Guimli/Vectrex-Repair-Manual/Manuel de réparation Vectrex 20220410.pdf

# Vectrex - Manuel de réparation

par Nicolas Weill
avec l’assistance de Flore Netter Remerciement spécial à Pascal, Jeremy et Gérald pour leurs Vectrex Relecture par les membres de l’association MO5

Révision du 12 mars 2022

*Merci d’envoyer vos commentaires, corrections ou propositions de traduc-tion sur le Github https://github.com/Guimli/Vectrex-Repair-Manual

## Contents

1 Précaution | 7
2 Panne récurente | 7
3 Métodologie de réparation | 9
4 Schématique | 9
5 Relevés Oscilloscope | 15

2

3

4

5

6 Documentation technique et composant de substitution | 77

6

## 1 Précaution

Risque électrique

Images/Electric-Shock.png Les consoles Vectrex contiennent un tube cathodique. De hautes

tensions sont présentes dans l’équipement électronique, même après l’ar-rêt de la console. Ne manipuler pas une Vectrex sans les connaissances électrique spécifiques requises.

## 2 Panne récurente

### 2.1 Pas de son et pas d’image

- Vérifier l’interrupteur SW301. Cet interrupteur est connu pour se gripper avec les années. Il faut alors ouvrir l’arrière, ajouter du dégrippant et actionner les contacts pour diffuser le dégrimpant. Passer eventuellement du papier de verre sur les contact si vous constatez une oxydation.
- Vérifier le fusible F101. Remplacer le fusible si besoin. Si le fusible saute systématiquement, les cas les plus fréquents de court circuit se situent sur les composant IC101 (LM340), IC102 (7905) et IC401 (LM379).

### 2.2 Pas de son et point blanc

- IC207 (PIA 6522) est le principale responsable des pannes sur la console Vectrex. Le remplacer est toujours la première opération à effectuer.
- L’absence de son indique que l’ensemble processeur, ROM, RAM et PIA ne fonctionne pas correctement. Si le PIA a déjà été remplacé sans succès, la cause la plus probable est une corruption de la ROM IC201 (2363).
- Cas de pannes multiples : Il est possible que plusieurs pannes brouilles l’analyse. Par exemple, une panne partielle de l’interrupteur SW301 pourra interrompre le -13V provoquant un point blanc. Et une panne de l’ampli-ficateur audio IC103 (LM386) pourra provoquer une absence de son.

### 2.3 Présence de son, mais point blanc

- Vérifier la présence des tensions sur J204 (+5V, -5V, -13V). L’absence de -13V génére un point blanc et peut révéler un problème avec l’interrupteur SW301 ou la diode zener DZ102.
- La cause la plus fréquente de point blanc sur l’écran est une panne de IC207 (PIA 6522).

7

- Il y a de nombreuses pannes pouvant générer un point blanc. Reportez vous aux relevés d’oscilloscope pour corriger les problèmes d’images/point blanc.

### 2.4 Autre problème d’image

- Reportez vous aux relevés d’oscilloscope pour corriger les problèmes d’images/point blanc.
- Un problème d’image rare mais difficile à diagnotiquer peut provenir du
cable J301. Les contacts à l’interieur sont sertis et non soudés. Il est donc possible de voir apparitre de l’oxydation sur les contact ou dans la jonc-tion cable-contact. Ce problème est invisble de l’extéruieur et nécessite de retirer les contacts du cable pour inspection.
- Problème rare d’image se décalant lors des mouvements de la manette : remplacer IC302 (CD4052D).

8

## 3 Métodologie de réparation

Une approche efficace de diagnotic consiste à diviser le circuit en section et proceder à une analyse par dichotomie.

- Commencer toujours par vérifier le fonctionnement de l’interrupteur SW301. Celui-ci peut-être partiellement défectueux. Les niveaux de tensions se-ront néanmoins correct. Mais une seule des deux bobines du secondaire du transformateur T102 sera exploité, générant une usure et une surchauffe de plusieurs éléments de l’alimentaion. Ainci qu’une instabillité plus grande sur les niveaux de tension. Ce qui générera des vibration de l’image.
- Vérifier les niveau de tension sur le connecteur J204.
- Vérifier les broches 3, 6,9 et 10 de IC302 (4052B). Si le signaux de ces bro-chezs sont incorrects, alors le problème se situe dans la partie numérique de la LogicBoard (IC201 à IC208, IC301 et IC304).

## 4 Schématique

### 4.1 PowerBoard

9

1N4005 D504

# 0.3uH 0.8A GND


To view a copy of this license, visit http://creativecommons.org/licenses/by-sa/4.0/ Attribution-ShareAlike 4.0 International License. This work is licensed under the Creative Commons R404

File: PowerBoard.kicad_sch Sheet: / or send a letter to Creative Commons, PO Box 1866, Mountain View, CA 94042, USA.

Id: 1/1 Title: Vectrex Power Board

### 4.2 LogicBoard

11

IRQB 21 RWB 22 CS2B 23 CS1 24 PHI2 25 D7 26 D6 27 D5 28 D4 29 | PA1 | 3 D3 30 D2 31 D1 32 D0 33 RESB 34 RS3 35 RS2 36 RS1 37 RS0 38 | CA2 39 PA2 | 4 CA1 40 PA3 | 5 PA4 | 6 PA5 | 7 PA6 | 8 PA7 | 9
+5V | +5VA R²²⁴ ⁶⁸⁰

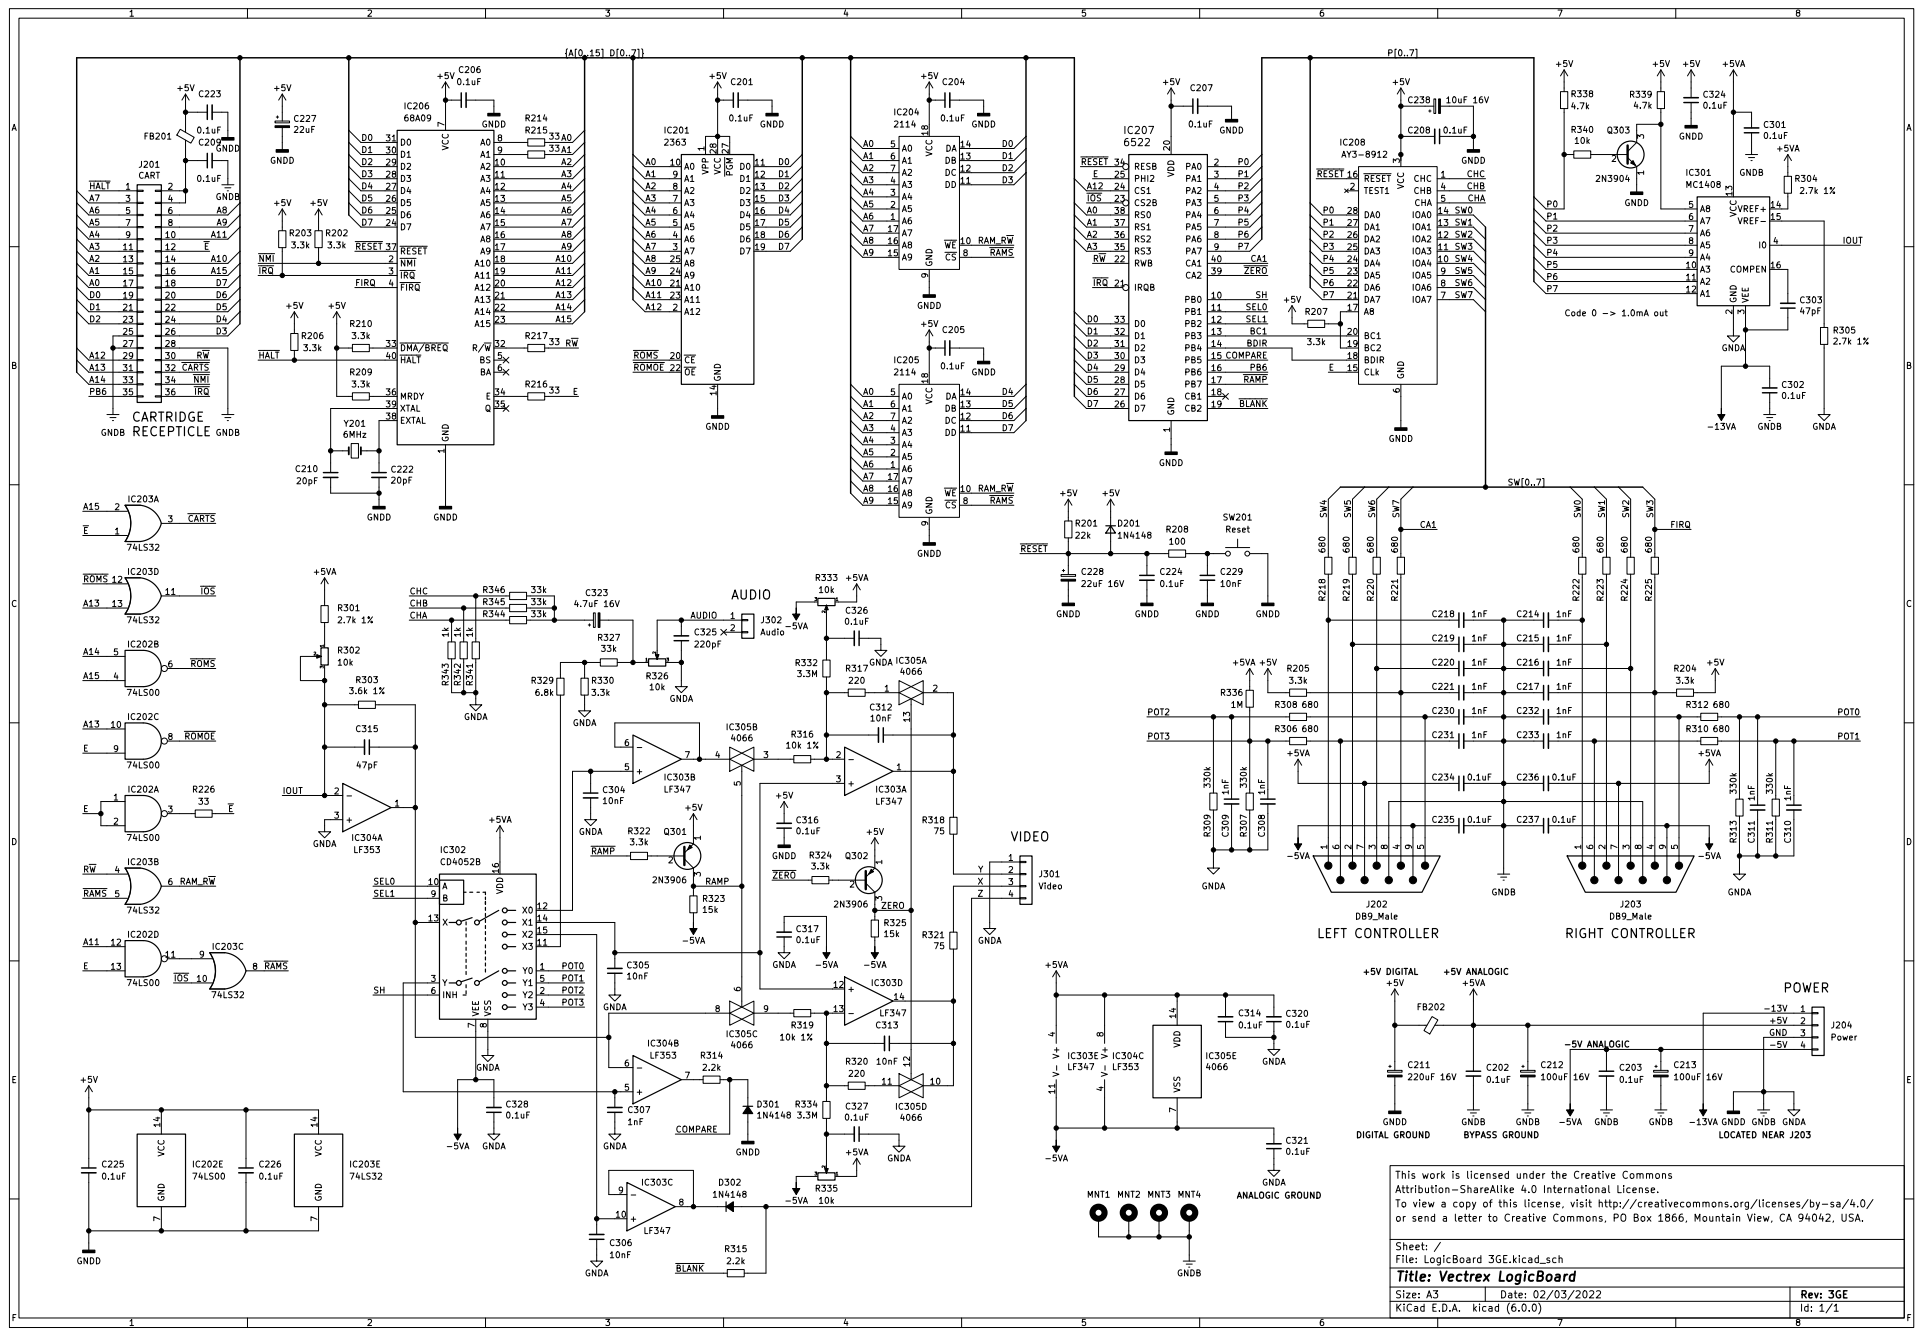
[picture p23: page 12]

1 A2 10 A3 11 A4 12 A5 13 A6 14 A7 15 A8 16 A9 17 A10 18 A11 19 ~{NMI} 2 A12 20 A13 21 A14 22 A15 23 D7 24 D6 25 D5 26 D4 27 D3 28 D2 29 ~{IRQ} 3 D1 30 D0 31 R/~{W}32 ~{DMA/BREQ} 33 E

1 A0 10 D0 11 D1 12 D2 13 GND 14 D3 15 D4 16 D5 17 D6 18 D7 19 A12 2 ~{CE} 20 A10 21 ~{OE} 22 A11 23 A9 24 A8 25 ~{PGM}27 VCC 28 A7 3 A6 4 A5 5 A4 6 A3 7 A2 8 A1 9

LOCATED NEAR J203 ANALOGIC GROUND VIDEO

To view a copy of this license, visit http://creativecommons.org/licenses/by-sa/4.0/ Attribution-ShareAlike 4.0 International License. This work is licensed under the Creative Commons

File: LogicBoard 3GE.kicad_sch Sheet: / or send a letter to Creative Commons, PO Box 1866, Mountain View, CA 94042, USA.

Id: 1/1 Title: Vectrex LogicBoard

### 4.3 CRT Board

13


To view a copy of this license, visit http://creativecommons.org/licenses/by-sa/4.0/ Attribution-ShareAlike 4.0 International License. This work is licensed under the Creative Commons YOKE401 HORIZONTAL C515

File: CRTBoard.kicad_sch Sheet: / or send a letter to Creative Commons, PO Box 1866, Mountain View, CA 94042, USA.

Id: 1/1 Title: Vectrex CRT Board

## 5 Relevés Oscilloscope

Les relevés d’oscilloscope sont classés par identifiant de composant.. Reportez vous au chapitre Métodologie de diagnostic pour ...

### 5.1 IC201 - 2363

Description : ROM interne contenant le programme d’initialisation de la Vectrex, ainsi que le jeu Minestorm.

Une corruption de la ROM peut être détecté par un reset régulier du processeur comme dans le relevé oscilloscope ci-dessous correspondant à une des broches d’adresse du processeur :


Il est necessaire de disposer d’une autre ROM déjà programmée pour remplacer IC201. Il est possible de remplacer la ROM par une EPROM de type 27C64.
La lecture du contenu de la ROM dans un programmeur compatible doit retourner les checksums 7931, B796 ou 7ADB. Les différentes versions de ROM sont interchangeables dans les différentes versions de Vectrex. La version la plus réçente, et donc à préférer, est la version dont le checksum est 7ADB.

15

### 5.1.1 Broche 1 (VPP)

Tension de programmation. Connecté au +5V logique.

### 5.1.2 Broche 2 à 10, 21, 23, 24,25 (A0 à A12)

Voir IC206 Broches 8 à 21 (A0 à A13).

### 5.1.3 Broche 11 à 13 et 15 à 19 (D0 à D7)

Voir IC206 Broches 24 à 31 (D0 à D7).

### 5.1.4 Broche 14 (GND)

Masse logique, 0V.

### 5.1.5 Broche 20 (ChipEnable)

Voir IC202 Broche 6 (Porte 2 sortie - ROMS).

### 5.1.6 Broche 22 (OutputEnable)

Voir IC202 Broche 8 (Porte 3 sortie - ROMOE).

### 5.1.7 Broche 27 (PGM)

Utilisé pour la programmation de la PROM en usine. Connecté au +5V logique.

### 5.1.8 Broche 28 (VCC)

Alimentation, +5V logique.

16

### 5.2 IC202 - 74LS00

Description : Quadruple porte NAND

### 5.2.1 Broche 1 et 2 (Porte 1 entrée - Enable)

Les broches 1 & 2 sont connectés à la broche 34 du processeur IC206 (broche Enable).
Voir IC206 Broche 34 (Enable).

### 5.2.2 Broche 3 (Porte 1 sortie - Enable)

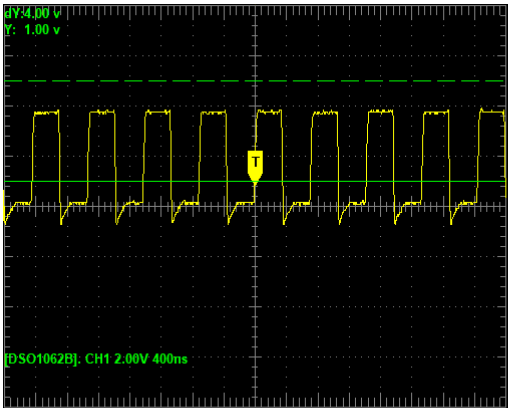
[picture p24: figure]

- En cas d’absence de signal, vérifier les broches 1 et 2 de IC202. Si les signaux sont correct, remplacer IC202.

### 5.2.3 Broche 4 et 5 (Porte 2 entrée - A14 et A15)

Voir IC206 Broches 22 et 23 (A14 et A15).

### 5.2.4 Broche 6 (Porte 2 sortie - ROMS)

Cette broche est connectée a la broche OE (Output Enable) de la ROM IC201. Elles devraient toujours être a un niveau de tension de 0V sauf en cas d’utilisa-

17 tion d’une cartouche de jeu. Si ce n’est pas le cas, vérifier les briches 4 et 5 de IC202. Remplacer IC202 si nécessaire.

### 5.2.5 Broche 7 (GND)

Masse, 0V

### 5.2.6 Broche 8 (Porte 3 sortie - ROMOE)

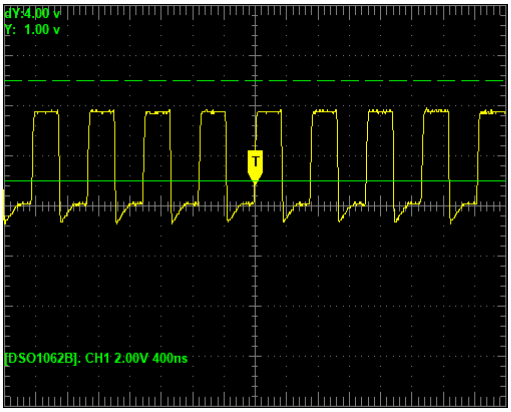
[picture p25: figure]

### 5.2.7 Broche 9 (Porte 3 entrée - Enable)

Voir IC206 Broche 34 (Enable).

- La broche 9 est connectés à la broche 34 du processeur IC206 (broche Enable). Une absence de signal sur cette broche indique un problème avec le processeur. Vérifier R216, XTAL201, et remplacer le processeur IC206 si nécessaire.

18

### 5.2.8 Broche 10 (Porte 3 entrée - A13)

19

### 5.2.9 Broche 11 (Porte 4 sortie)


20

### 5.2.10 Broche 12 (Porte 4 entrée - A11)

### 5.2.11 Broche 13 (Porte 4 entrée - Enable)

Voir IC206 Broche 34 (Enable)

- La broche 13 est connectés à la broche 34 du processeur IC206 (broche Enable). Une absence de signal sur cette broche indique un problème avec le processeur. Vérifier R216, XTAL201, et remplacer le processeur IC206 si nécessaire.

### 5.2.12 Broche 14 (VCC)

Alimentation +5V continu.

21

### 5.3 IC203 - 74LS32

Description : Quadruple porte OR

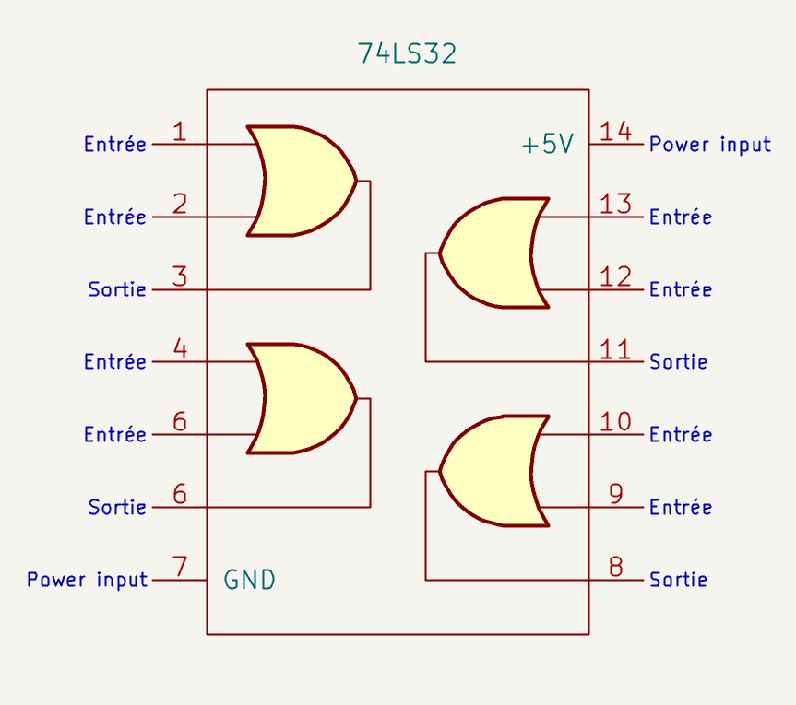
[picture p26: figure]

### 5.3.1 Broche 1 (Porte 1 entrée - Enable)

Voir IC202 Broche 3 (Porte 1 sortie - Enable).

22

### 5.3.2 Broche 2 (Porte 1 entrée - A15)

23

### 5.3.3 Broche 3 (Porte 1 sortie - CARTS)

### 5.3.4 Broche 4 (Porte 2 entrée - RW)

Voir IC206 Broche 32 (RW).

### 5.3.5 Broche 5 (Porte 2 entrée - RAMS)

Voir IC203 Broche 8 (Porte 3 sorite - RAMS).

24

### 5.3.6 Broche 6 (Porte 2 sortie - RAM_RW)

### 5.3.7 Broche 7 (GND)

Masse logique, 0V.

25

### 5.3.8 Broche 8 (Porte 3 sorite - RAMS)

26

### 5.3.9 Broche 9 (Porte 3 entrée)

### 5.3.10 Broche 10 (Porte 3 entrée - IOS)

Voir IC203 Broche 11 (Porte 4 sortie - IOS).

27

### 5.3.11 Broche 11 (Porte 4 sortie - IOS)

### 5.3.12 Broche 12 (Porte 4 entrée - ROMS)

Voir IC202 Broche 6 (Porte 2 sortie - ROMS).

28

### 5.3.13 Broche 13 (Porte 4 entrée - A13)

### 5.3.14 Broche 14 (VCC)

Alimentation +5V logique.

29

### 5.4 IC204, IC205 - 2114

Description : RAM 1K×4bits, 300ns

### 5.4.1 Broche 1 à 7, 15, 16, 17 (A0 à A9)

Voir IC206 Broches 8 à 21 (A0 à A13).

### 5.4.2 Broche 8 (ChipSelect)

Voir IC203 Broche 8 (Porte 3 sorite - RAMS).

### 5.4.3 Broche 9 (GND)

Masse logique, 0V.

### 5.4.4 Broche 10 (WriteEnable)

Voir IC203 Broche 6 (Porte 2 sortie - RAM_RW).

### 5.4.5 Broche 11 à 14 (DA à DD)

Voir IC206 Broches 24 à 31 (D0 à D7).

### 5.4.6 Broche 18 (VCC)

Alimentation +5V logique.

30

### 5.5 IC206 - 68A09

Decription : Processeur 8bits cadencé à 1,5 MHz

### 5.5.1 Broche 1 (GND)

Masse logique, 0V.

### 5.5.2 Broche 2 (NMI)

Cette broche devrait être a +5V, sauf en cas d’utilisation de certaines cartouches de jeu spécifique.

### 5.5.3 Broche 3 (IRQ)

Cette broche devrait être a +5V, sauf en cas d’utilisation de certaines cartouches de jeu spécifique.

### 5.5.4 Broche 4 (FIRQ)

Cette broche devrait être a +5V, sauf en ca d’appuie sur le bouton 4 de la manette de droite.

### 5.5.5 Broche 7 (VCC)

Alimentation +5V logique.

31

### 5.5.6 Broches 8 à 21 (A0 à A13)

32

### 5.5.7 Broches 22 et 23 (A14 et A15)

- Ces broches devraient toujours être à un niveau de tension de 4V, sauf en cas d’utilisation d’une cartouche de jeu. Si ce n’est pas le cas, vérifier XTAL201, C210 et C222, et remplacer IC206 si nécessaire.

33

### 5.5.8 Broches 24 à 31 (D0 à D7)

34

### 5.5.9 Broche 32 (RW)

Images/IC206/pin32.bmp

### 5.5.10 Broche 33 (DMA)

Cette broche est connecté au +5V logique.

35

### 5.5.11 Broche 34 (Enable)

Images/IC206/pin34.bmp

- Une absence de signal sur cette broche indique un problème avec le processeur. Vérifier R216, XTAL201, et remplacer le processeur IC206 si nécessaire.

36

### 5.5.12 Broche 35 (Q)

### 5.5.13 Broche 36 (MReady)

Cette broche est connecté au +5V logique.

### 5.5.14 Broche 37 (Reset)

Réinitialise IC206, IC207 et IC208. Actif sur un niveau bas.

- Cette broche devrait être a +5V sauf si vous appuyez sur le bouton Reset. Si ce n’est pas le cas, remplacer C228, C224, C229 et D201.

37

### 5.5.15 Broche 38 (ExTal)

- Le quartz étant un composant sensible, cette mesure nécessite de postion-ner votre sonde d’oscilloscope en mode 10X.
- En cas d’absence de signal, remplacer Y201, C210, C222. Puis remplacer IC206 si nécessaire.

38

### 5.5.16 Broche 39 (XTal)

- Le quartz étant un composant sensible, cette mesure nécessite de postion-ner votre sonde d’oscilloscope en mode 10X.
- En cas d’absence de signal, remplacer Y201, C210, C222. Puis remplacer IC206 si nécessaire.

### 5.5.17 Broche 40 (Halt)

39

### 5.6 IC207 - 6522

Decription : Extension de port pour processeur 68A09

### 5.6.1 Broche 1 (GND)

Masse logique, 0V.

### 5.6.2 Broche 2 à 9 (PA0 à PA7)

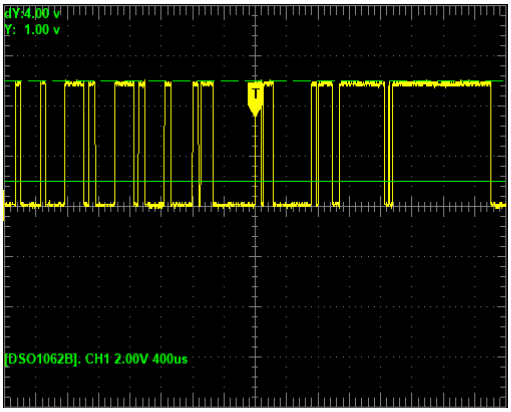
[picture p27: figure]

### 5.6.3 Broche 10 (PB0)

Voir IC302 Broche 6 (Inhibit)

### 5.6.4 Broche 11 et 12 (PB1 & PB2)

Voir IC302 Broche 9 et 10 (Select A et B)

40

### 5.6.5 Broche 13 (PB3)

41

### 5.6.6 Broche 14 (PB4)

42

### 5.6.7 Broche 15 (PB5)

### 5.6.8 Broche 16 (PB6)

Cette broche devrait être a +5V, sauf en cas d’utilisation de certaines cartouches de jeu spécifique.

43

### 5.6.9 Broche 17 (PB7)

44

### 5.6.10 Broche 19 (CB2)

### 5.6.11 Broche 20 (VCC)

Alimentation +5V logique.

### 5.6.12 Broche 21 (IRQB)

Voir IC206 Broche 3 (IRQ).

### 5.6.13 Broche 22 (RWB)

Voir IC206 Broche 32 (RW).

### 5.6.14 Broche 23 (CS2B)

Voir IC203 Broche 11 (Porte 4 sortie - IOS).

### 5.6.15 Broche 24 (CS1)

Voir IC201 Broches 8 à 21 (A0 à A13).

45

### 5.6.16 Broche 25 (Enable)

Voir IC206 Broche 34 (Enable).

### 5.6.17 Broche 26 à 33 (D0 à D7)

Voir IC206 Broches 24 à 31 (D0 à D7).

### 5.6.18 Broche 34 (Reset)

Voir IC206 Broche 37 (Reset).

### 5.6.19 Broche 35 et 38 (A0 à A3)

Voir IC206 Broches 8 à 21 (A0 à A13).

### 5.6.20 Broche 39 (CA2)

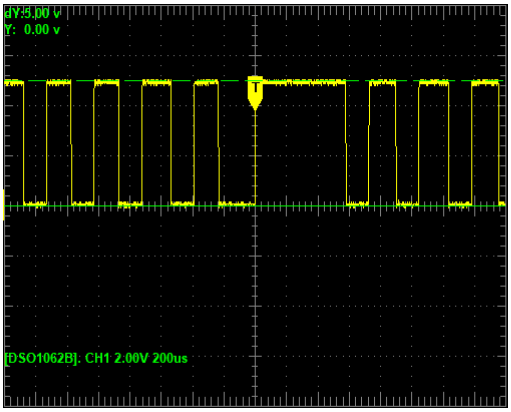
[picture p28: figure]

### 5.6.21 Broche 40 (CA1)

46

### 5.7 IC208 - AY-3-8912

Description : Générateur de son

### 5.7.1 Broche 1, 4 et 5 (CHC, CHB, CHA)

### 5.7.2 Broche 3 (VCC)

Alimentation, +5V logique.

### 5.7.3 Broche 6 (GND)

Masse logique, 0V.

### 5.7.4 Broche 7 à 14 (IOA0 à IOA7)

Connecté aux boutons des manettes. En l’absence d’activité des manettes, ces broches devraient retournées +5V.

### 5.7.5 Broche 15 (Clock)

Voir IC206 Broche 34 (Enable)

### 5.7.6 Broche 16 (Reset)

Voir IC206 Broche 37 (Reset)

### 5.7.7 Broche 17 (A8)

Connecté au +5V logique via R207.

### 5.7.8 Broche 18 (BDir)

Voir IC207 Broche 14 (PB4)

### 5.7.9 Broche 19 (BC2)

Connecté au +5V logique via R207.

### 5.7.10 Broche 20 (BC1)

Voir IC207 Broche 13 (PB3)

### 5.7.11 Broche 21 à 28 (DA0 à DA7)

Voir IC207 Broche 2 à 9 (PA0 à PA7)

47

### 5.8 IC301 - MC-1408P8

Description : convertisseur numérique-analogique 8 bits.

### 5.8.1 Broche 1 (Range / Non connecté)

Non utilisé.

### 5.8.2 Broche 2 (GND)

Masse analogique, 0V.

### 5.8.3 Broche 3 (VEE)

-13V analogique.

### 5.8.4 Broche 4 (IOUT)

Il n’est pas possible d’effectuer des mesures fiables sur cette broche. Mesurer IC302 Broche 13 (Common X) pour vérifier le fonctionnement de IC301.

### 5.8.5 Broche 5 à 12 (DA0 à DA7)

Voir IC207 Broche 2 à 9 (PA0 à PA7)

### 5.8.6 Broche 13 (VCC)

Alimentation, +5V analogique.

### 5.8.7 Broche 14 (VREF+)

+5V analogique via R304.

### 5.8.8 Broche 15 (VREF-)

Masse analogique via R305.

### 5.8.9 Broche 16 (Compensation)

Environ -10V continu, via C303.

48

### 5.9 IC302 - 4052B

Description : double multiplexeur/démultiplexeur.

Le premier multiplexeur prend en entré (broche 13) le signal en provenance du DAC IC301. Et redirige ces signaux en fonction des besoins vers les broches 11 (son digitalisé), 12 (signal vidéo vertical), 14 (?) et 15 (intensité de l’image). Le second multiplexeur est utilisé pour sélectionner le potentiomètre des manettes analogique (broche 1, 2, 4 et 5) qui devra être lu (broche 3). L’analyse de ces broches est donc inutile pour corriger un problème d’image de la Vectrex.

### 5.9.1 Broche 1, 2, 4 et 5 (Y channels In/Out)

Broche de lecture des potentiomètres des joysticks. Sans interet pour réparer les problème commum de la Vectrex.

### 5.9.2 Broche 3 (Common Y)

Broche de sortie des potentiomètres des joysticks. Sans interet pour réparer les problème commum de la Vectrex.

### 5.9.3 Broche 6 (Inhibit)

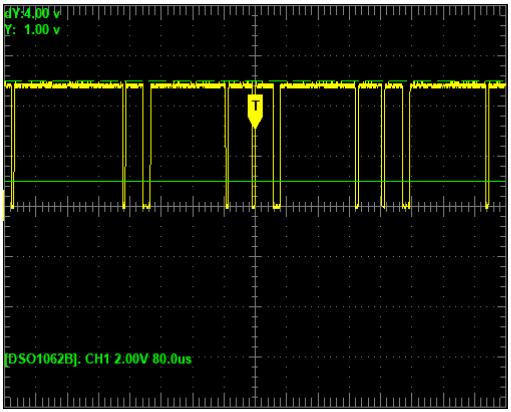
[picture p29: figure]

- En cas d’absence de signal, remplacer IC207 (PIA 6522).

49

### 5.9.4 Broche 7 (VEE)

-5V analogique.

### 5.9.5 Broche 8 (VSS)

Masse analogique, 0V.

### 5.9.6 Broche 9 et 10 (Select A et B)

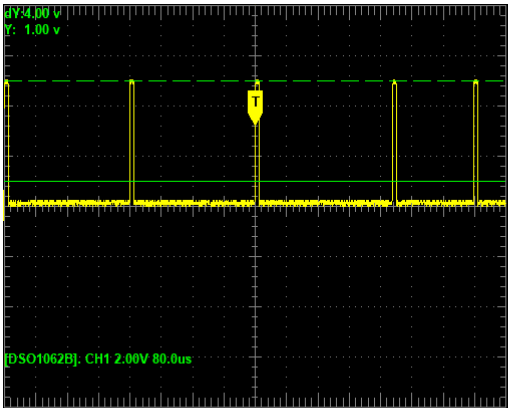
[picture p30: figure]

- En cas d’absence de signal, remplacer IC207 (PIA 6522)

### 5.9.7 Broche 11 (X Channel 3)

Sortie pour les sons digitalisés. Il n’y a pas de son digitalisé dans l’écran de démarrage de la Vectrex ou dans le jeu Minestorm. La tesion sur cette broche est 0V.

50

### 5.9.8 Broche 12 (X Channel 0)

- En cas d’absence de signal, vérifier les signaux sur les broches 6, 9, 10 et
13. Si tous ces signaux sont correct, alors remplacer le CD4052B et/ou le condensateur C304.
- En cas de signal déformé, vérifier les signaux sur les broches 6, 9, 10 et
13. Vérifier la présence de la tension -5V sur le cable d’alientation J204. Si tous ces signaux sont correct, alors remplacer le CD4052B.

51

### 5.9.9 Broche 13 (Common X)

- En cas d’absence de signal, vérifier les signaux sur les broches 5 à 12 de IC301 (MC-1408P8), vérifier la présence de la tension -13V sur le cable d’alimetation J204. Si tous ces signaux sont correct, remplacer IC301 et IC304.

### 5.9.10 Broche 14 (X Channel 1)

Sortie pour le controle direct et simultané d’amplification des signaux X et Y. Cette sortie permet d’effectuer des zoom ou de changer la précision du signal. Cette sortie n’est pas utilisé dans l’écran de démarrage de la Vectrex ou dans le jeu Minestorm. La tesion sur cette broche est 0V.

52

### 5.9.11 Broche 15 (X Channel 2)

- En cas d’absence de signal, vérifier les signaux sur les broches 6, 9, 10 et
13. Si tous ces signaux sont correct, alors remplacer le CD4052B et/ou le condensateur C306.
- En cas de signal déformé, vérifier les signaux sur les broches 6, 9, 10 et
13. Vérifier la présence de la tension -5V sur le cable d’alientation J204. Si tous ces signaux sont correct, alors remplacer le CD4052B.

### 5.9.12 Broche 16 (VDD)

Alimentation, +5V analogique.

53

### 5.10 IC303 - LF347

### 5.10.1 Broche 1 (Sortie)

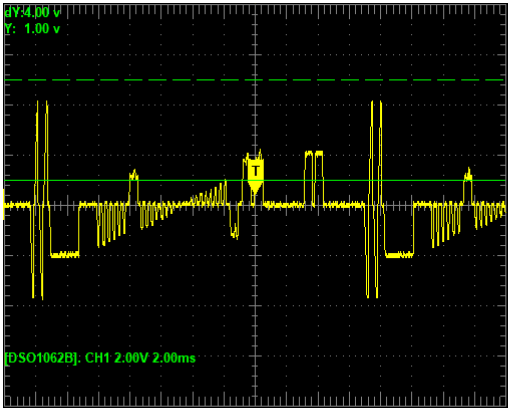
[picture p31: figure]

54

### 5.10.2 Broche 2 (Entrée)

### 5.10.3 Broche 3 (Entrée)

Voir IC302 Broche 14 (X Channel 1)

### 5.10.4 Broche 4

Alimentation, +5V analogique.

### 5.10.5 Broche 5 (Entrée)

Voir IC302 Broche 12 (X Channel 0)

### 5.10.6 Broche 6 (Entrée)

Voir IC303 Broche 7 (Sortie)

55

### 5.10.7 Broche 7 (Sortie)

56

### 5.10.8 Broche 8 (Sortie)

### 5.10.9 Broche 9 (Entrée)

Voir IC303 Broche 8 (Sortie)

### 5.10.10 Broche 10 (Entrée)

Voir IC302 Broche 15 (X Channel 2)

### 5.10.11 Broche 11

Masse analogique, 0V.

### 5.10.12 Broche 12 (Entrée)

Voir IC302 Broche 14 (X Channel 1)

57

### 5.10.13 Broche 13 (Entrée)

58

### 5.10.14 Broche 14 (Sortie)

59

### 5.11 IC304 - LF353

### 5.11.1 Broche 1 (Sortie)

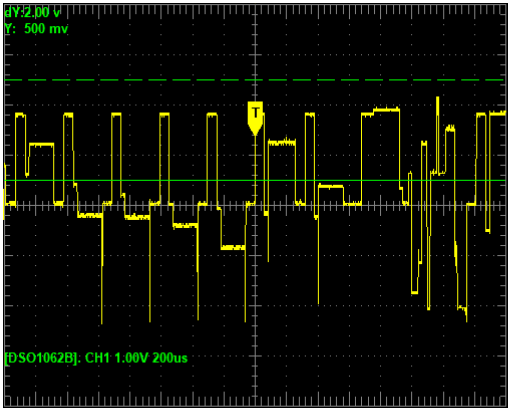
[picture p32: figure]

### 5.11.2 Broche 2 (Entrée)

Voir IC301 Broche 4 (IOUT)

### 5.11.3 Broche 3 (Entrée)

Masse analogique, 0V.

### 5.11.4 Broche 4

Masse analogique, 0V.

### 5.11.5 Broche 5 (Entrée)

Voir IC302 Broche 3 (Common Y)

### 5.11.6 Broche 6 (Entrée)

Voir IC304 Broche 1 (Sortie)

60

### 5.11.7 Broche 7 (Sortie)

### 5.11.8 Broche 8

Alimentation, +5V analogique.

61

### 5.12 IC305 - 4066B

### 5.12.1 Broche 1 (Entrée)

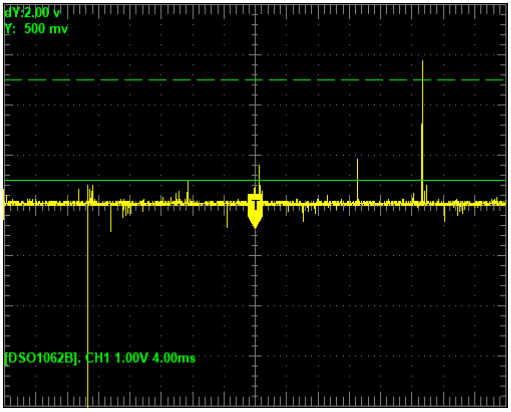
[picture p33: figure]

62

### 5.12.2 Broche 2 (Sortie)

63

### 5.12.3 Broche 3 (Sortie)

64

### 5.12.4 Broche 4 (Entrée)

65

### 5.12.5 Broche 5 (Entrée)

66

### 5.12.6 Broche 6 (Entrée)

### 5.12.7 Broche 7 (VSS)

-5V analogique

### 5.12.8 Broche 8 (Entrée)

Voir Broche 13 (Common X)

67

### 5.12.9 Broche 9 (Sortie)

68

### 5.12.10 Broche 10 (Sortie)

69

### 5.12.11 Broche 11 (Entrée)

70

### 5.12.12 Broche 12 (Entrée)

71

### 5.12.13 Broche 13 (Entrée)

### 5.12.14 Broche 14 (VDD)

Alimentation, +5V analogique.

72

### 5.13 J301 - Connecteur Vidéo

### 5.13.1 Bleu

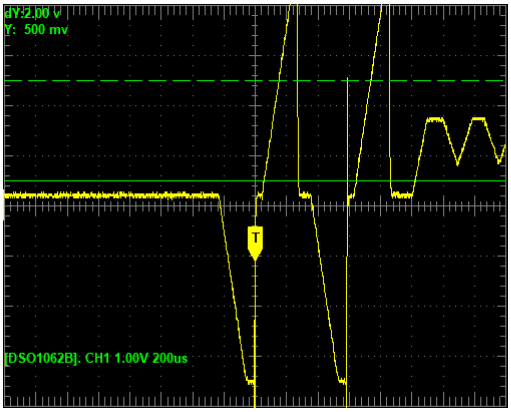
[picture p34: figure]

73

### 5.13.2 Rouge

74

### 5.13.3 Jaune

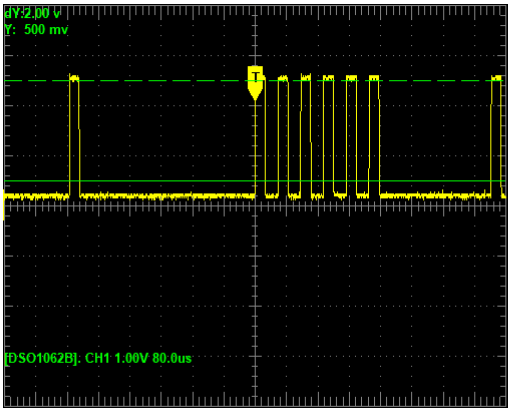
[picture p35: figure]

75

### 5.14 J302 - Audio

### 5.14.1 Noir

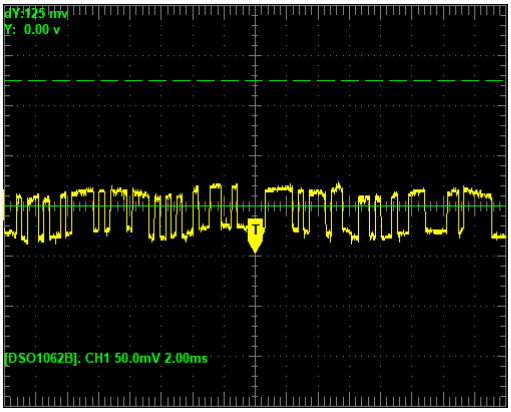
[picture p36: figure]

76

## 6 Documentation technique et composant de substitution

Référence | Nom | Documentation technique
IC101 | LM340 | https://www.ti.com/lit/gpn/lm340
| LM7805 | https://www.ti.com/lit/gpn/lm7800
IC102 | LM7905 | https://www.ti.com/lit/gpn/lm79
IC103 | LM386-3 | https://www.ti.com/lit/ds/symlink/lm386.pdf
IC201 | 2363
| 284001-1
| M27C64 | https://www.mouser.fr/...cd00000519-1204359.pdf (https://www.mouser.fr/datasheet/2/389/stmicroelectronics_cd00000519-1204359.pdf)
IC202 | 74LS00 | https://www.ti.com/lit/ds/symlink/sn5400.pdf
IC203 | 74LS32 | https://www.ti.com/lit/ds/symlink/sn54ls32-sp.pdf
IC204 | 2114 | https://hardware.speccy.org/datasheet/2114.pdf
| TMM314AP | https://console5.com/techwiki/.../TMM314APL.pdf (https://console5.com/techwiki/images/7/7c/TMM314APL.pdf)
IC205 | 2114 | https://hardware.speccy.org/datasheet/2114.pdf
| TMM314AP | https://console5.com/techwiki/.../TMM314APL.pdf (https://console5.com/techwiki/images/7/7c/TMM314APL.pdf)
IC206 | 68A09
IC207 | 6522A
IC208 | AY3-8912 | https://console5.com/.../GI-AY-8910—AY-8912—AY-8913.pdf (https://console5.com/techwiki/images/f/f5/GI-AY-8910---AY-8912---AY-8913.pdf)
IC301 | MC1408P8
| DAC0808 | https://www.ti.com/lit/ds/symlink/dac0808.pdf
IC302 | 4052B | https://www.ti.com/lit/ds/symlink/cd4051b.pdf
IC303 | LF347 | https://www.ti.com/lit/ds/symlink/lf147.pdf
IC304 | LF353 | https://www.ti.com/lit/ds/symlink/lf353.pdf
IC305 | 4066B | https://www.ti.com/lit/ds/symlink/cd4066b-mil.pdf
IC401 | LM379 | https://console5.com/techwiki/images/0/02/LM379.pdf
IC501 | LM555 | https://www.ti.com/lit/gpn/lm555
| NE555 | https://www.ti.com/lit/gpn/ne555

77
