Guimli/Vectrex-Repair-Manual/Images/Audio.bmp

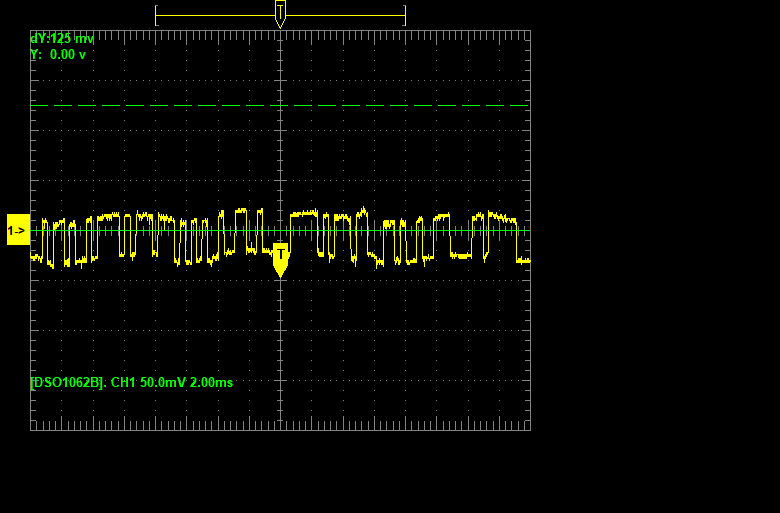
Images/Audio.bmp
