Guimli/Vectrex-Repair-Manual/Images/Electric-Shock.png

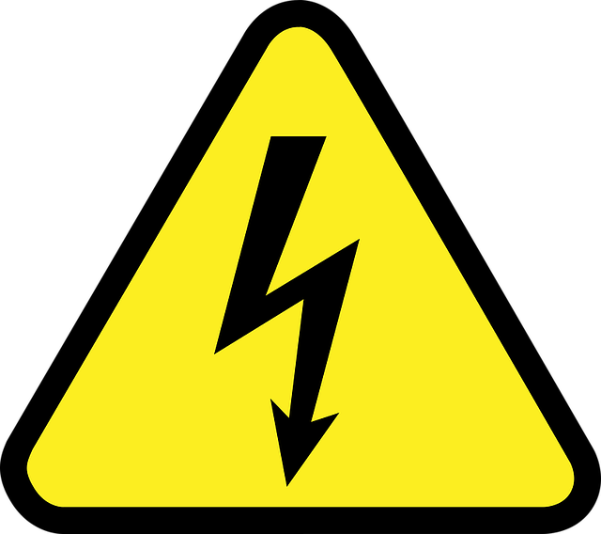
Images/Electric-Shock.png
