Guimli/Vectrex-Repair-Manual/Images/IC201/Dead ROM.bmp

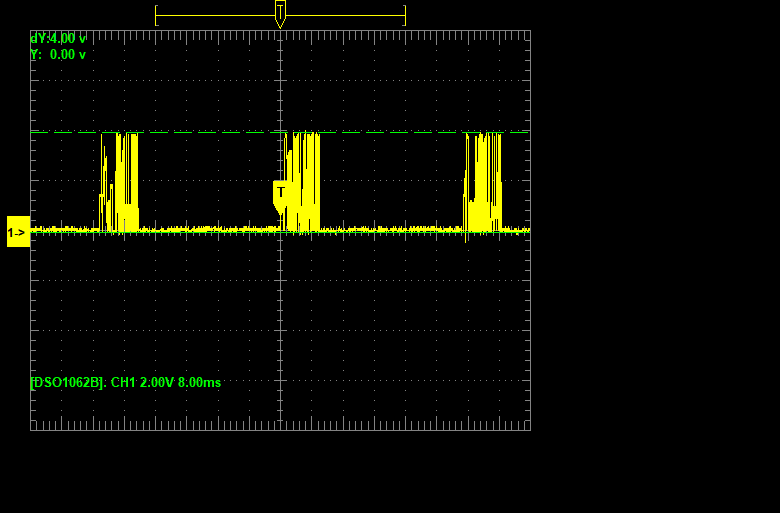
Images/IC201/Dead ROM.bmp
