Guimli/Vectrex-Repair-Manual/Images/IC203/74LS32_FR.png

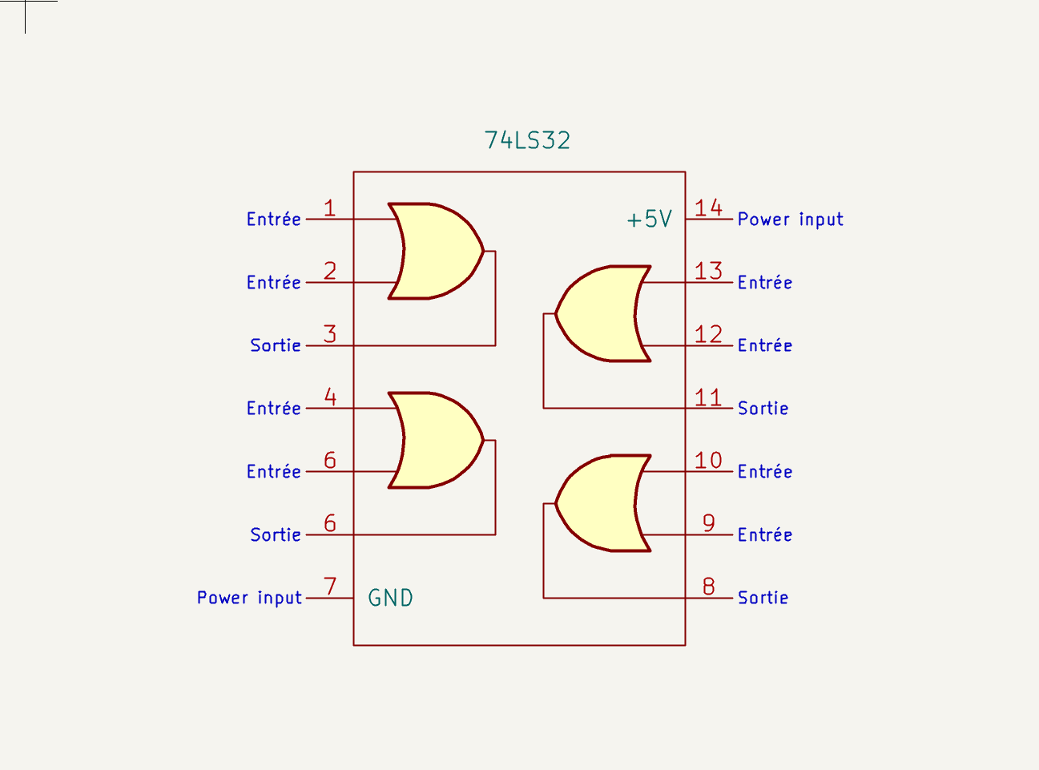
Images/IC203/74LS32_FR.png
