Guimli/Vectrex-Repair-Manual/Images/IC206/pin31.bmp

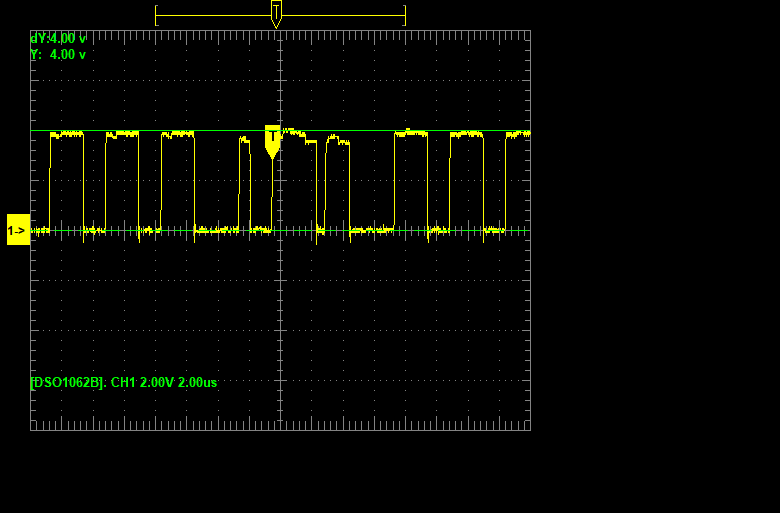
Images/IC206/pin31.bmp
