Guimli/Vectrex-Repair-Manual/Images/IC206/pin32.bmp

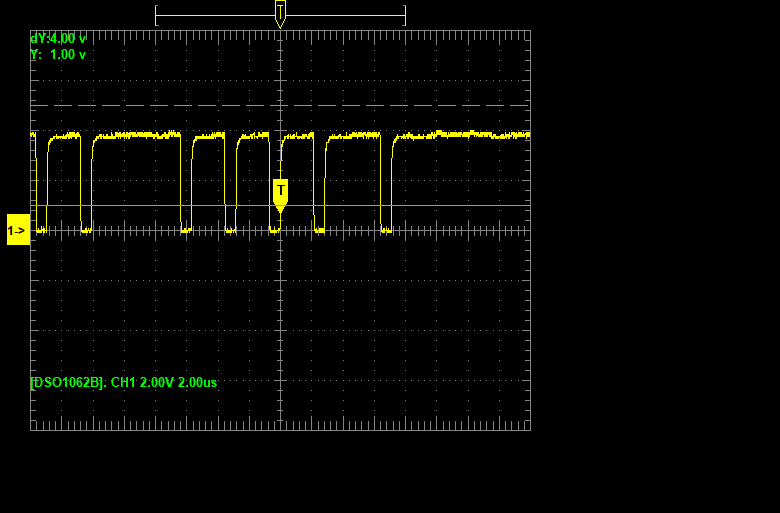
Images/IC206/pin32.bmp
