Guimli/Vectrex-Repair-Manual/Images/IC206/pin34.bmp

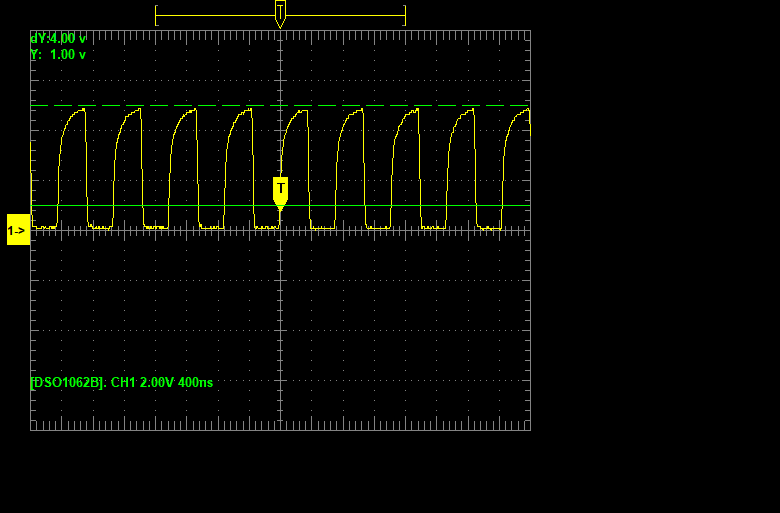
Images/IC206/pin34.bmp
