Guimli/Vectrex-Repair-Manual/Images/IC206/pin38.bmp

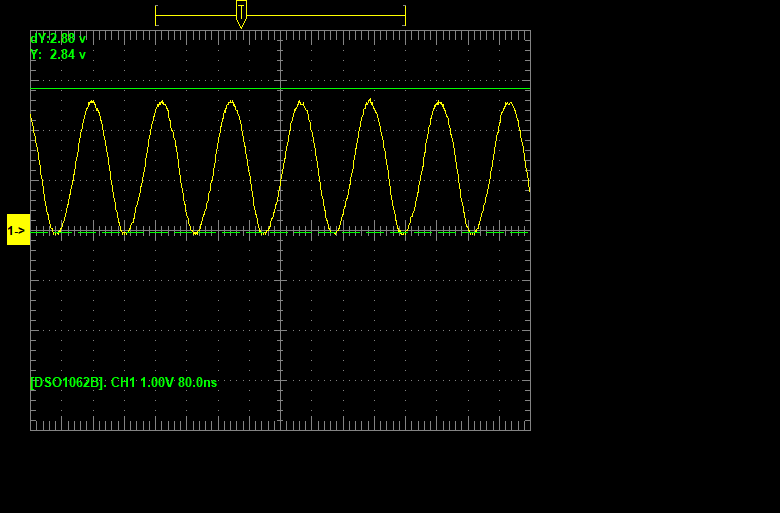
Images/IC206/pin38.bmp
