Guimli/Vectrex-Repair-Manual/Images/IC206/pin39.bmp

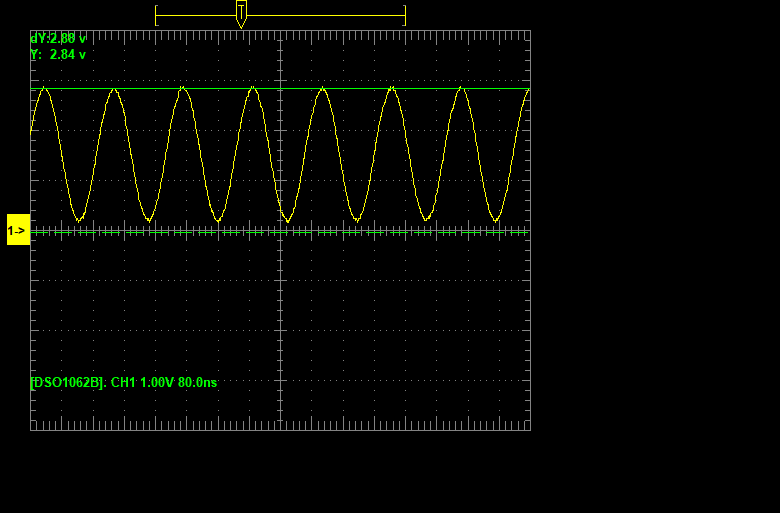
Images/IC206/pin39.bmp
