Guimli/Vectrex-Repair-Manual/Images/IC207/pin15.bmp

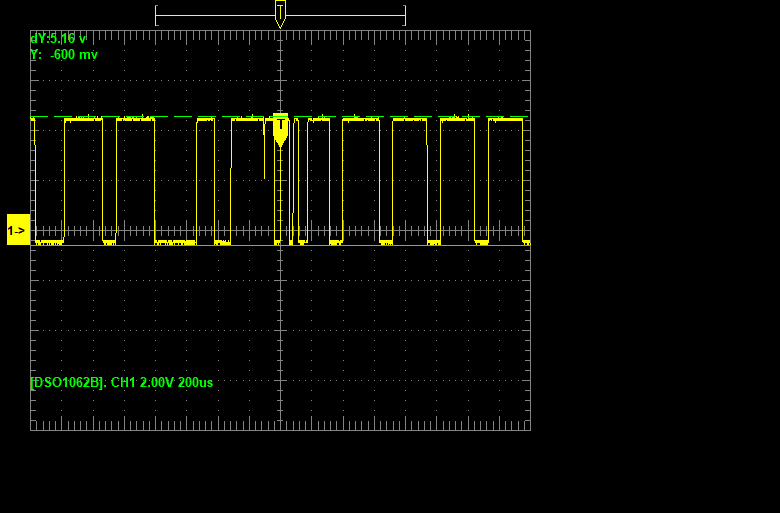
Images/IC207/pin15.bmp
