Guimli/Vectrex-Repair-Manual/Images/IC207/pin39.bmp

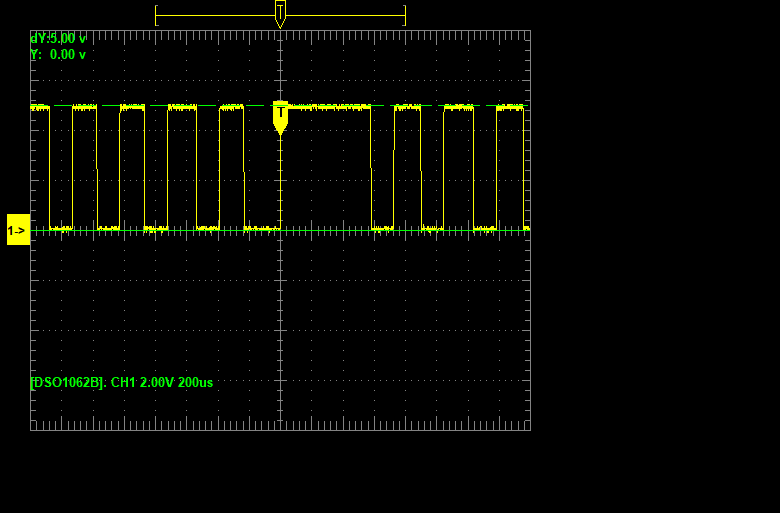
Images/IC207/pin39.bmp
