Guimli/Vectrex-Repair-Manual/Images/IC301/pin16.bmp

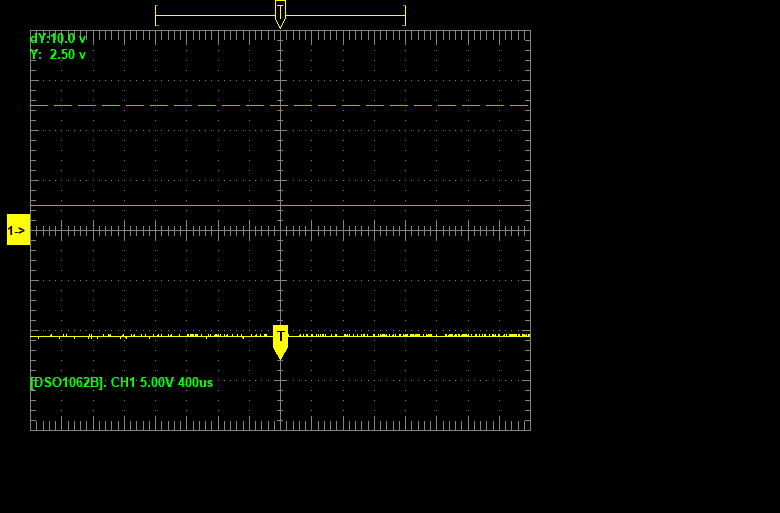
Images/IC301/pin16.bmp
