Guimli/Vectrex-Repair-Manual/Images/IC302/CD4052B.png

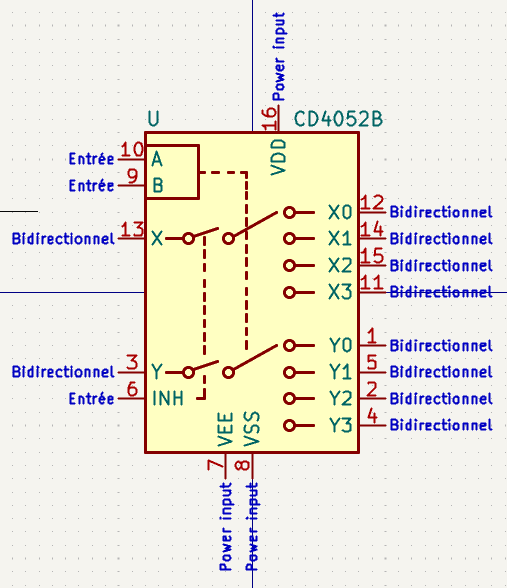
Images/IC302/CD4052B.png
