Guimli/Vectrex-Repair-Manual/Images/IC302/pin16.bmp

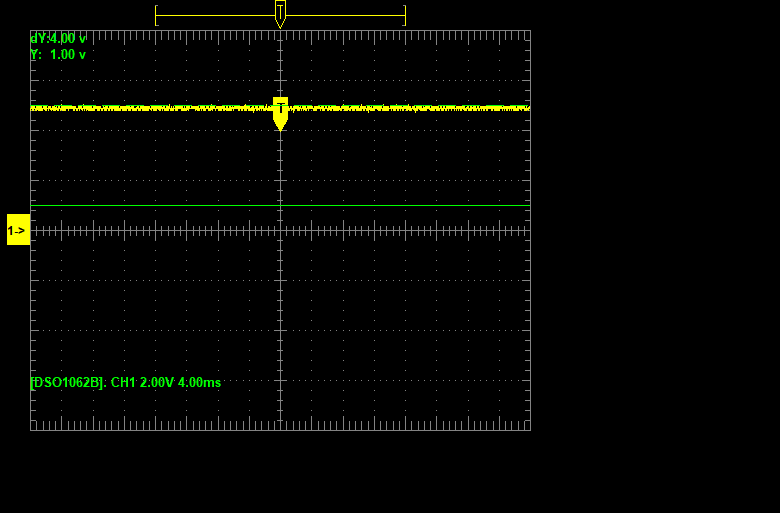
Images/IC302/pin16.bmp
