Guimli/Vectrex-Repair-Manual/Images/IC304/pin 1.bmp

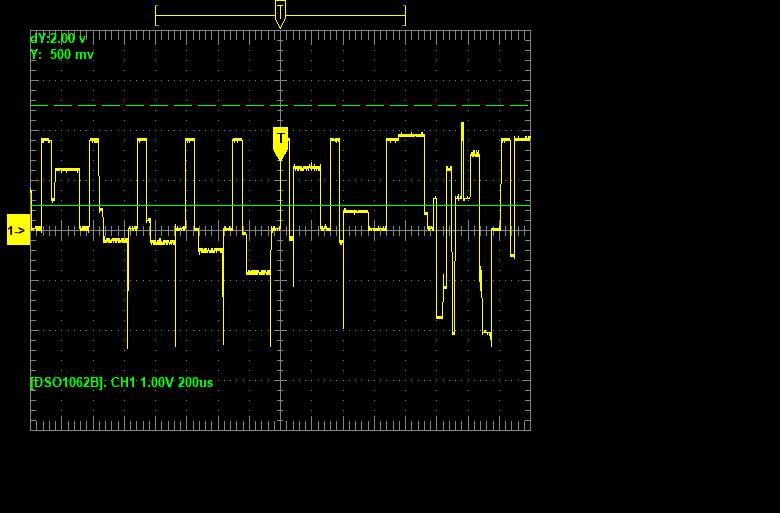
Images/IC304/pin 1.bmp
