Guimli/Vectrex-Repair-Manual/Images/IC305/pin1.bmp

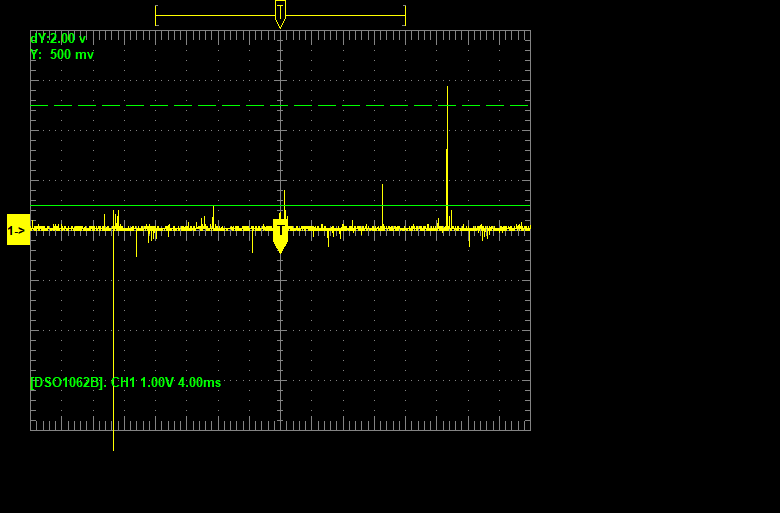
Images/IC305/pin1.bmp
