Guimli/Vectrex-Repair-Manual/Images/IC305/pin2.bmp

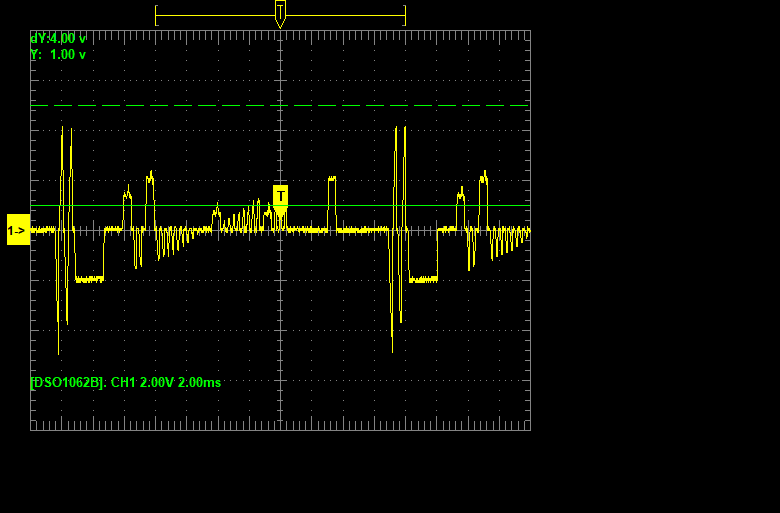
Images/IC305/pin2.bmp
