Guimli/Vectrex-Repair-Manual/Images/IC305/pin3.bmp

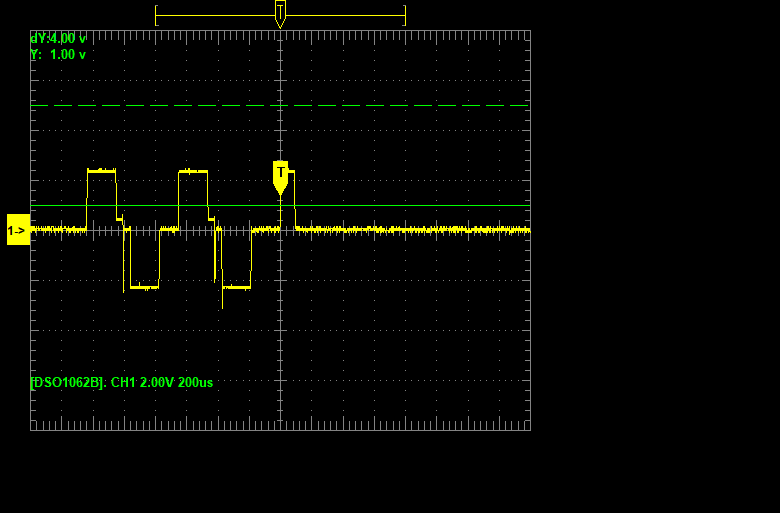
Images/IC305/pin3.bmp
