Guimli/Vectrex-Repair-Manual/Images/IC305/pin4.bmp

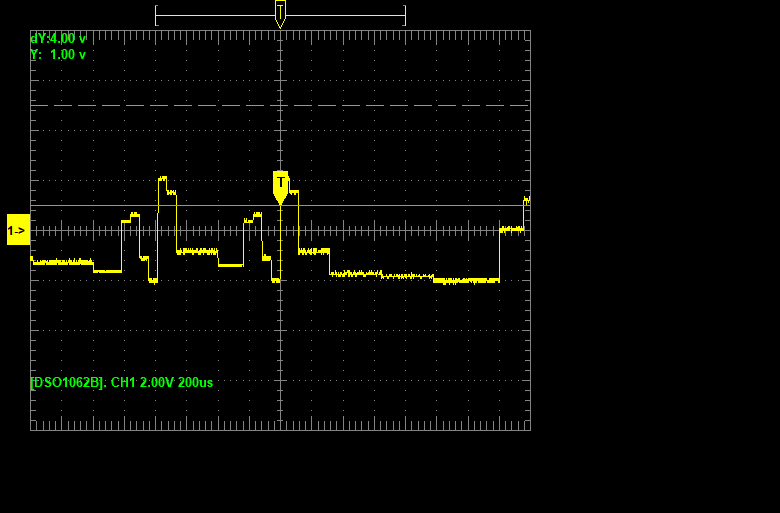
Images/IC305/pin4.bmp
