Guimli/Vectrex-Repair-Manual/Images/IC305/pin5.bmp

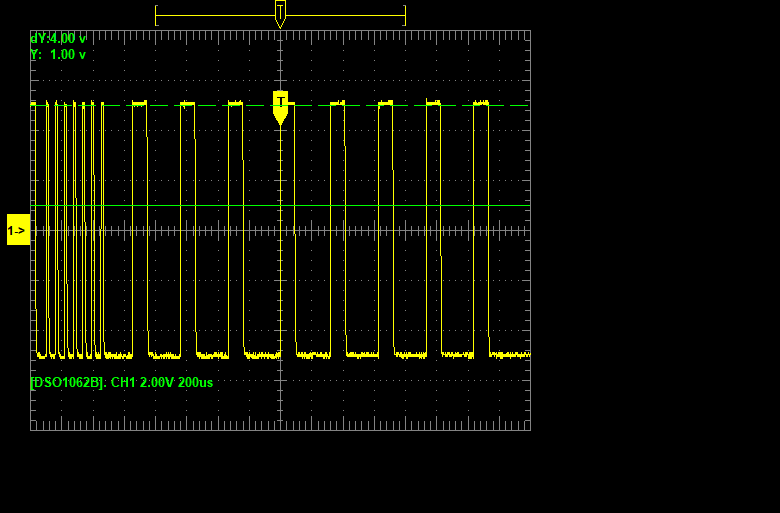
Images/IC305/pin5.bmp
