Guimli/Vectrex-Repair-Manual/Images/IC305/pin6.bmp

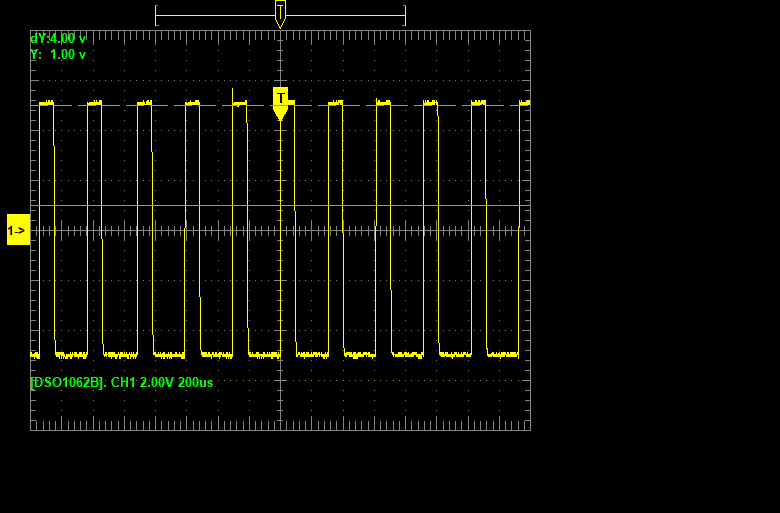
Images/IC305/pin6.bmp
