Guimli/Vectrex-Repair-Manual/Images/IC305/pin8.bmp

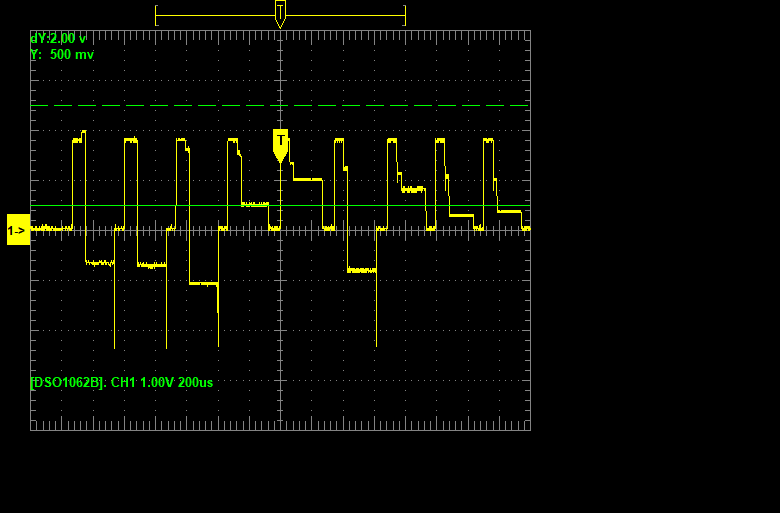
Images/IC305/pin8.bmp
