Guimli/Vectrex-Repair-Manual/Images/IC305/pin9.bmp

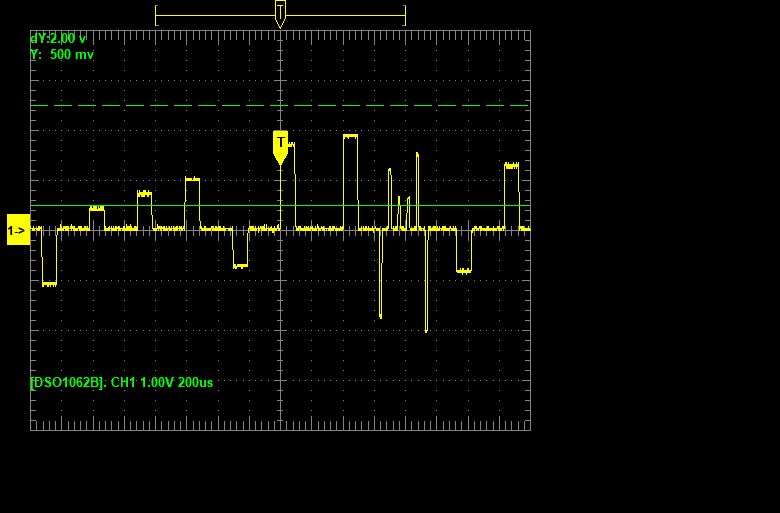
Images/IC305/pin9.bmp
