Guimli/Vectrex-Repair-Manual/Images/IC305/pin12.bmp

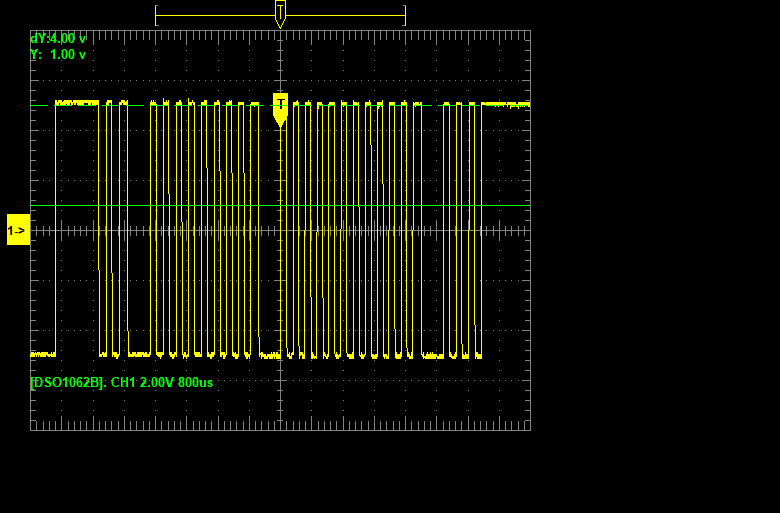
Images/IC305/pin12.bmp
