Guimli/Vectrex-Repair-Manual/Images/IC305/pin13.bmp

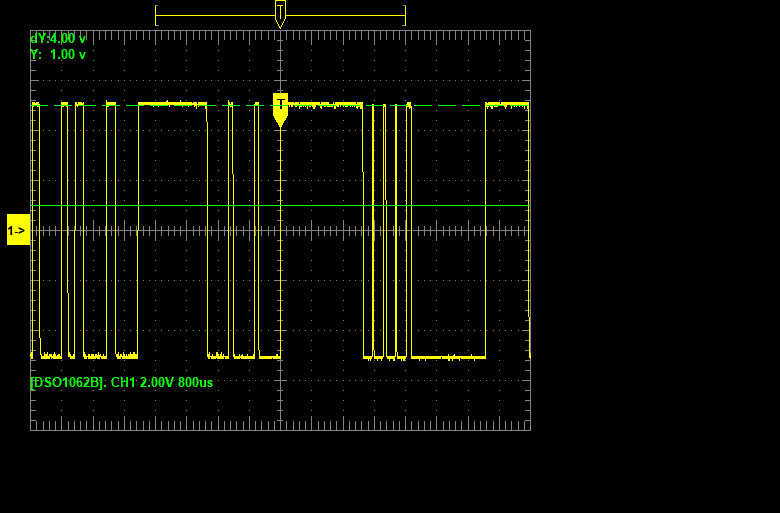
Images/IC305/pin13.bmp
