Guimli/Vectrex-Repair-Manual/Images/IC501/ic501_3.bmp

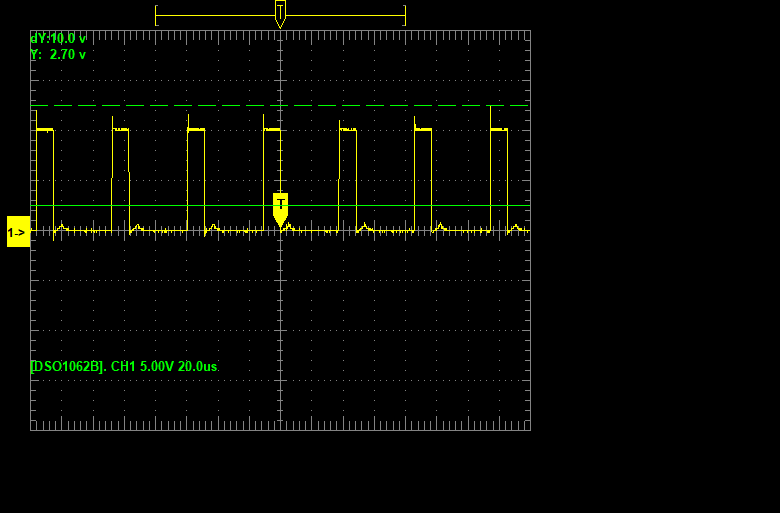
Images/IC501/ic501_3.bmp
