Guimli/Vectrex-Repair-Manual/Images/J301/j301_blue.bmp

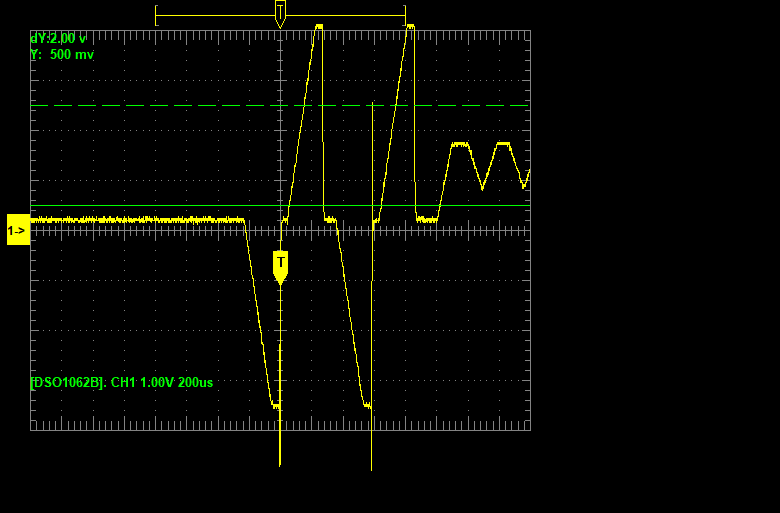
Images/J301/j301_blue.bmp
