Guimli/Vectrex-Repair-Manual/Images/J301/j301_red.bmp

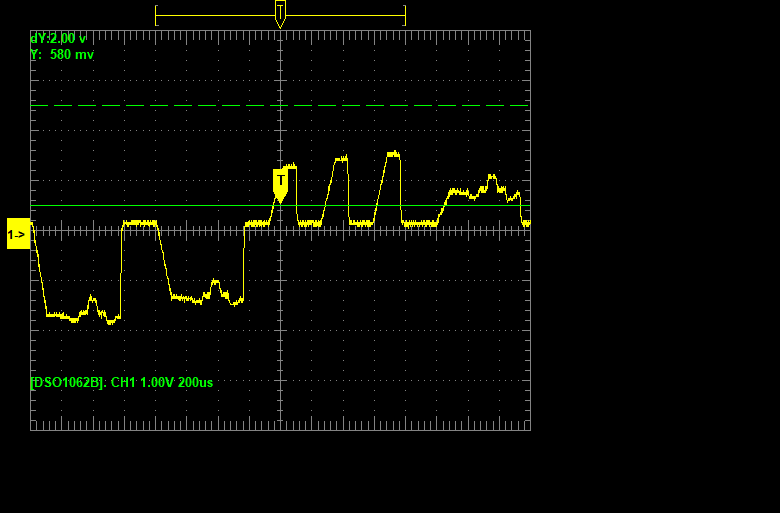
Images/J301/j301_red.bmp
