Guimli/Vectrex-Repair-Manual/Images/J301/j301_yellow.bmp

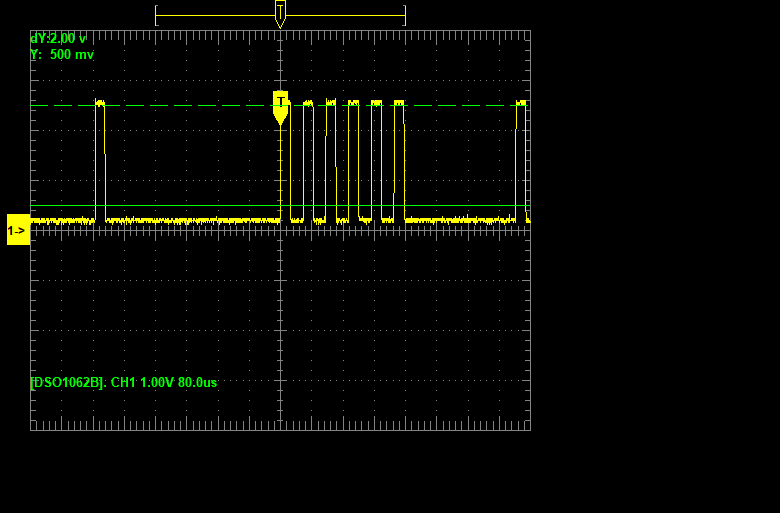
Images/J301/j301_yellow.bmp
