Guimli/Vectrex-Repair-Manual/Images/J301/j301_yellow_2.bmp

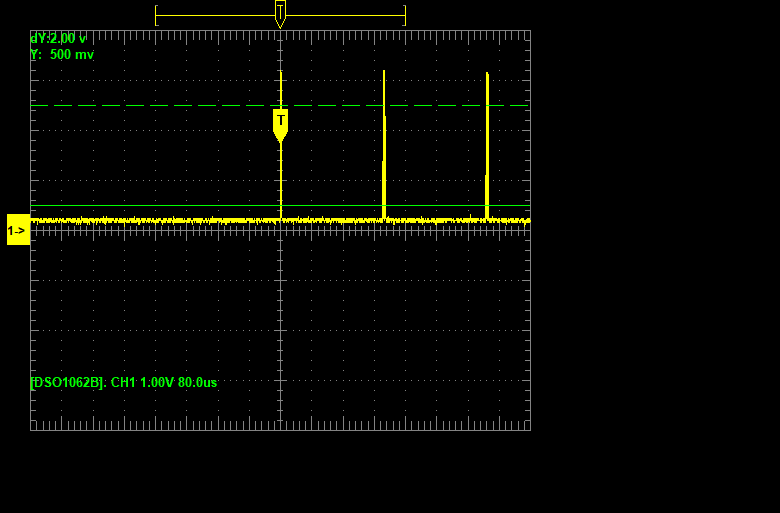
Images/J301/j301_yellow_2.bmp
