Guimli/Vectrex-Repair-Manual/Images/J401/J401_green.bmp

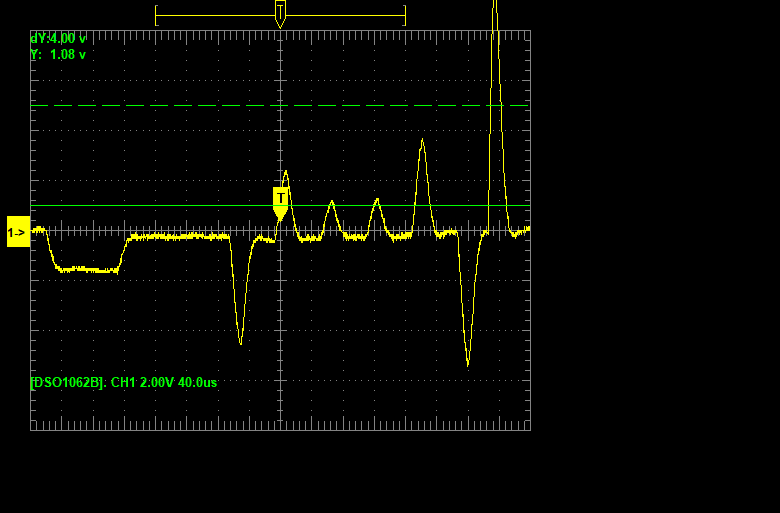
Images/J401/J401_green.bmp
