Guimli/Vectrex-Repair-Manual/Images/J401/J401_red.bmp

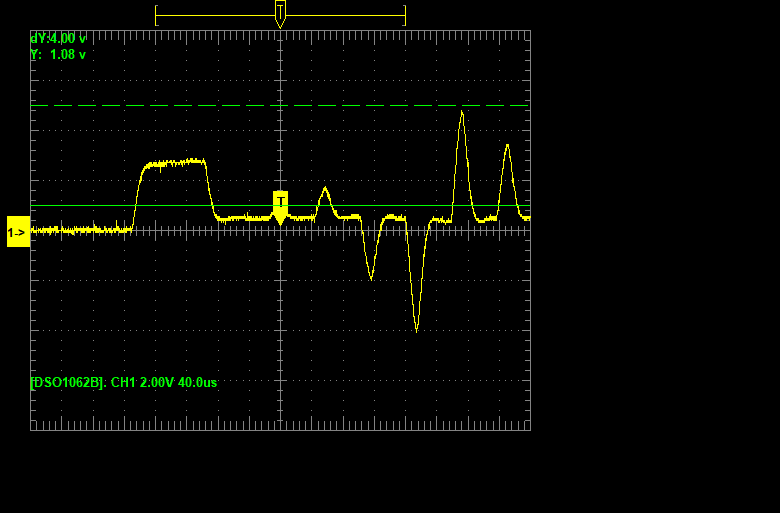
Images/J401/J401_red.bmp
