Guimli/Vectrex-Repair-Manual/Images/LM379/lm379_8.bmp

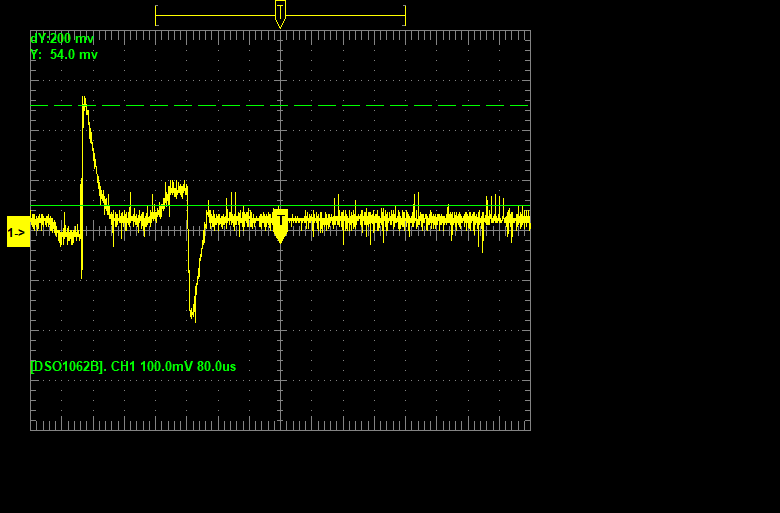
Images/LM379/lm379_8.bmp
