Guimli/Vectrex-Repair-Manual/Images/XTAL201/quartz.bmp

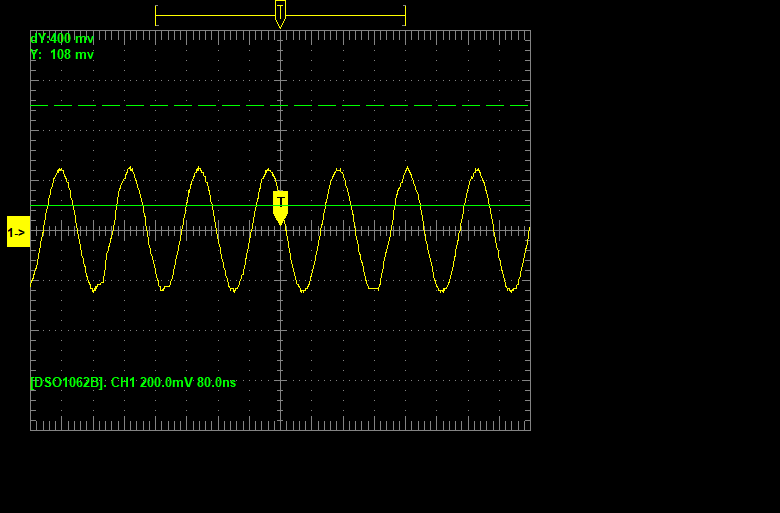
Images/XTAL201/quartz.bmp
