Guimli/Vectrex-Repair-Manual/(threads)

Thread 2 (2023-03-26):

Suggestion for troubleshooting display

fuji8bit, 2023-03-26:
Great document, here's another fix you can add to the troubleshooting display section.  I've fixed a few of these, usually after someone did a cap kit.

Symptoms:  Wavy vectors,  Louder than normal buzzing sound, large heatsink on power board hotter than usual.

Possible cause:  C404 or C411 negative leg not grounded.  More likely if capacitors have been replaced.

Fix:  Make sure capacitor is soldered to top and bottom pads, and there is continuite between negative leg and ground.

Guimli, 2023-03-27:
Thank you.
I hope to be able to write this document again one day. From my point of view, I have only done 50% of the work...
I have reworded it as follows:
- Following a capacitor replacement: vector undulation, buzzing louder than normal, main heatsink on the power supply board hotter than normal. This problem can occur due to the lack of a metallized hole on the C404 and C411 capacitors. Ensure that you have applied tin on both sides of the PCB for these capacitors. Check the continuity between the Vectrex ground and the corresponding pin of the capacitors.

Thread 3 (2024-06-29):

Suggestion add info on -13V missing

Guimli, 2024-06-29:
Output is measuring 0.6V with D106 missing.
If D107 is open, you'll see -1.2V at the -13V node

Thread 4 (2024-12-11):

Power Board Schematic Issue (IC401)

DanielLeguizamo, 2024-12-11:
It appears the inputs to IC401 are connected incorrectly. They should be going to pins 7/8 instead of 6/9. Also, there are two caps (C405/406) and resistors (R404/411) that should be on the non-inverting input of those op-amps.
