Guimli/Vectrex-Repair-Manual/(commit log)

2022-07-29 Add LogicBoard BoardView file
    [Vectrex_LogicBoard_3GE.brd]
2022-09-06 Update Schematic
